K1P5/yampad/img/ROTARY ENCODER MATRIX IDENTIFICATION.JPG

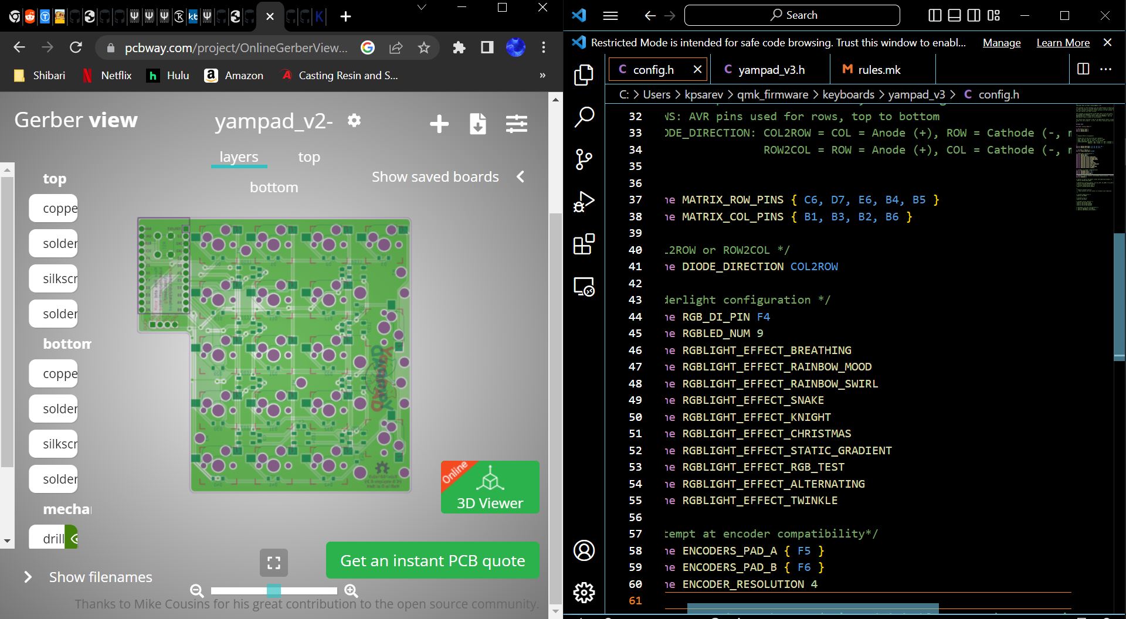
img/ROTARY ENCODER MATRIX IDENTIFICATION.JPG
