K1P5/yampad/pcb/K1P5 KiCAD Updates/Readme

K1P5 updates to Yampad, capturing currently "as-sold" state (rotary encoder + 2u "0" switch socket).
