K1P5/yampad/img/K1P5 YAMPAD PCB, 'AS-SOLD'.PNG

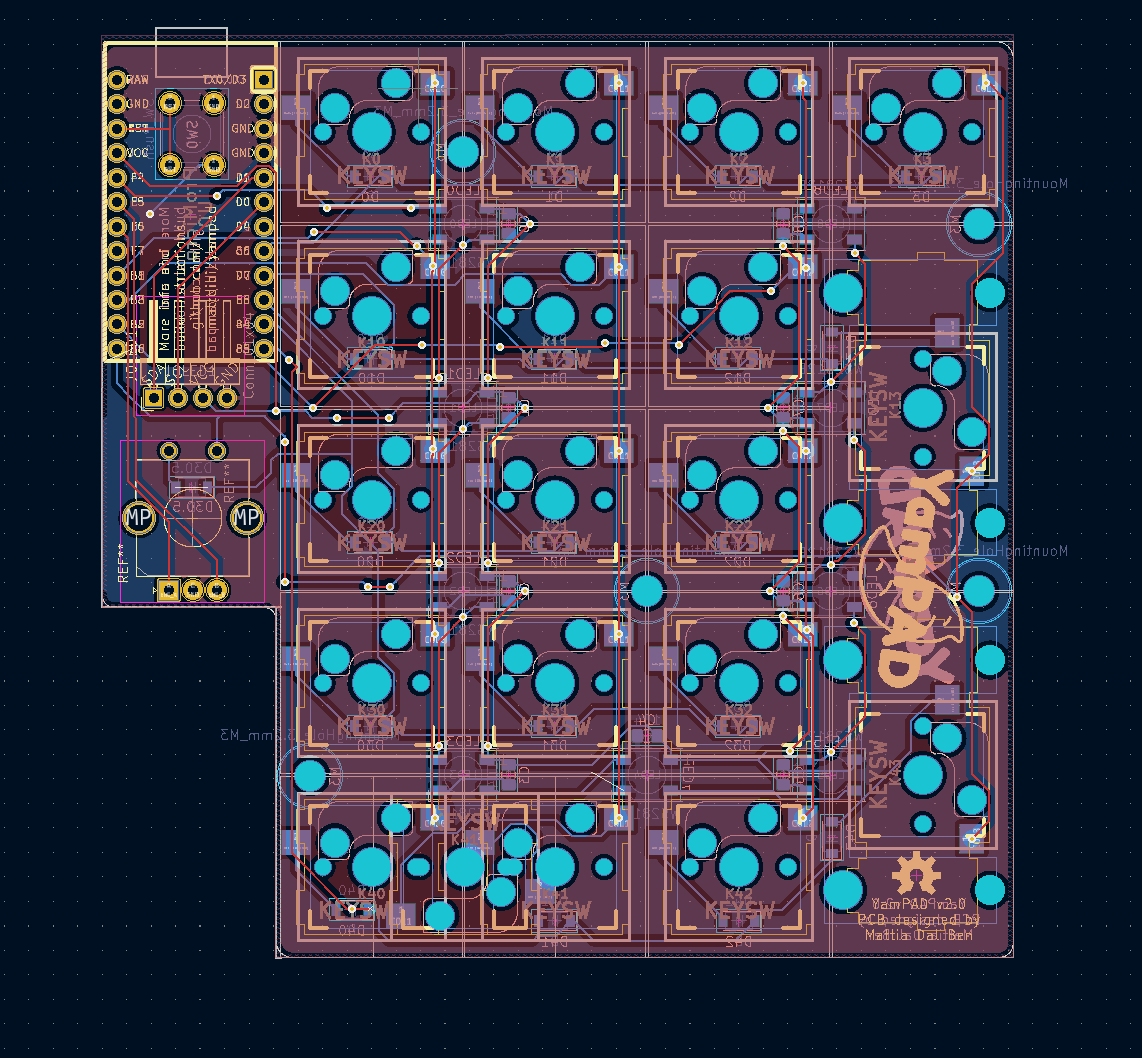
img/K1P5 YAMPAD PCB, 'AS-SOLD'.PNG
