K1P5/yampad/img/ROTARY ENCODER MATRIX IDENTIFICATION IMAGE 2.JPG

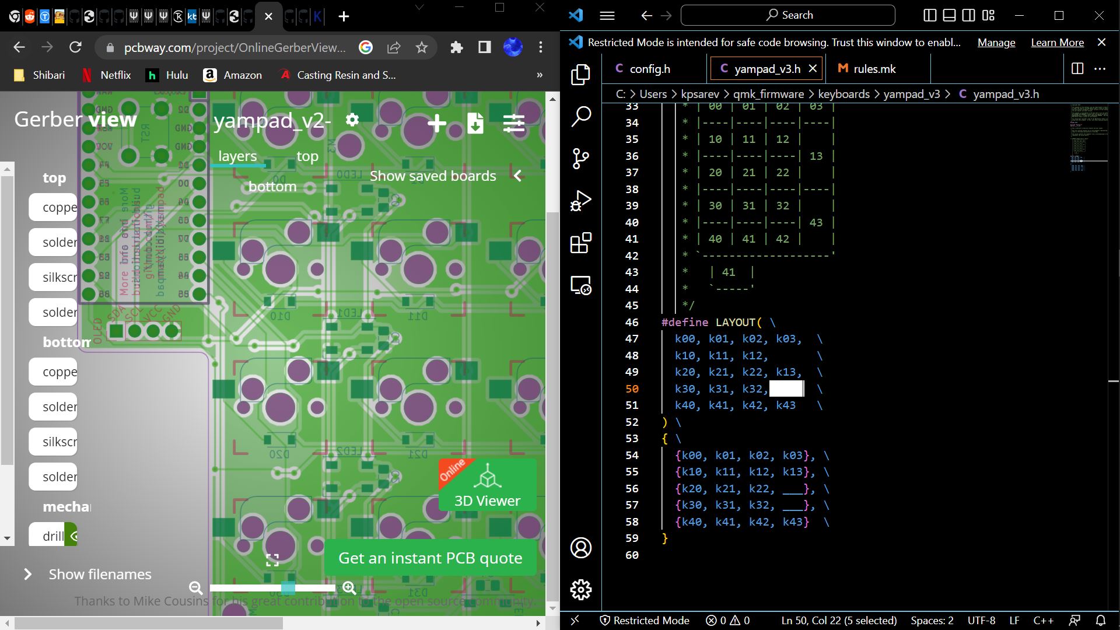
img/ROTARY ENCODER MATRIX IDENTIFICATION IMAGE 2.JPG
