K1P5/yampad/img/YAMPAD 2U '0' UPDATE.PNG

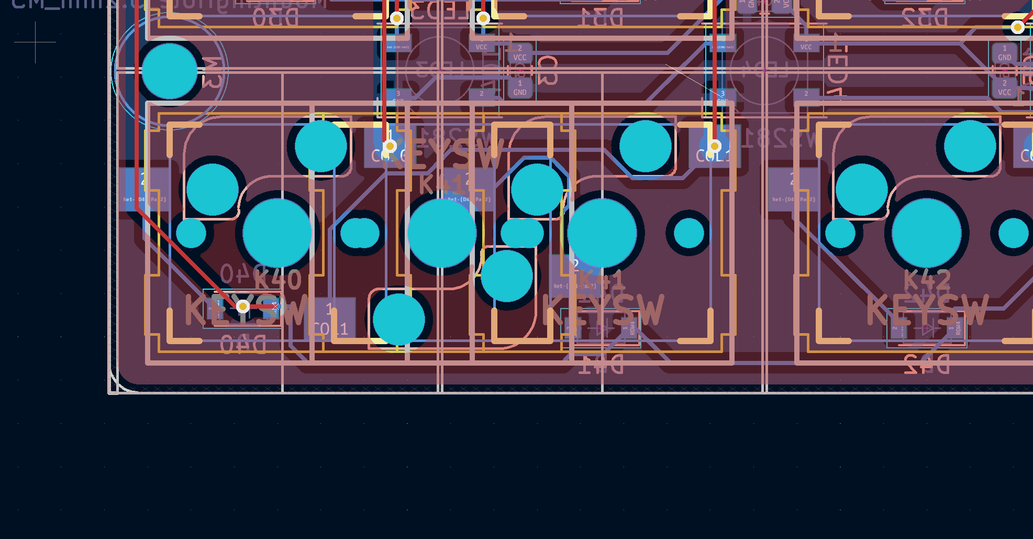
img/YAMPAD 2U '0' UPDATE.PNG
