K1P5/yampad/img/YAMPAD POTENIOMETER PCB UPDATE.PNG

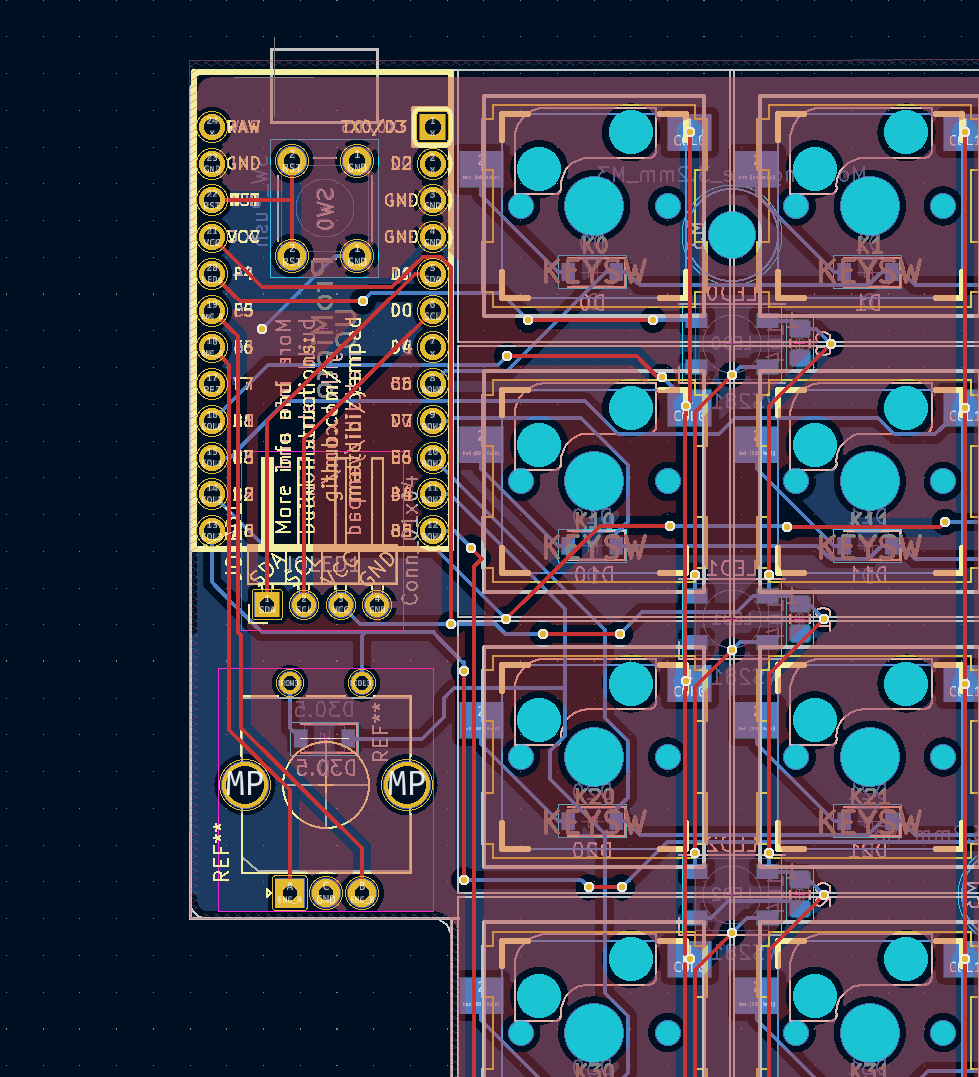
img/YAMPAD POTENIOMETER PCB UPDATE.PNG
