K1P5/yampad/firmware/QMK Files/yampad_v4/yampad_v4/config.h

/*
Copyright 2012 Jun Wako <wakojun@gmail.com>

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
You should have received a copy of the GNU General Public License
along with this program.  If not, see <http://www.gnu.org/licenses/>.
*/

#pragma once

#include "config_common.h"

/* key matrix size */
#define MATRIX_ROWS 5
#define MATRIX_COLS 4


/*
 * Keyboard Matrix Assignments
 *
 * Change this to how you wired your keyboard
 * COLS: AVR pins used for columns, left to right
 * ROWS: AVR pins used for rows, top to bottom
 * DIODE_DIRECTION: COL2ROW = COL = Anode (+), ROW = Cathode (-, marked on diode)
 *                  ROW2COL = ROW = Anode (+), COL = Cathode (-, marked on diode)
 *
*/
#define MATRIX_ROW_PINS { C6, D7, E6, B4, B5 }
#define MATRIX_COL_PINS { B1, B3, B2, B6 }

/* COL2ROW or ROW2COL */
#define DIODE_DIRECTION COL2ROW

/* Underlight configuration */
#define RGB_DI_PIN F4
#define RGBLED_NUM 9
#define RGBLIGHT_EFFECT_BREATHING
#define RGBLIGHT_EFFECT_RAINBOW_MOOD
#define RGBLIGHT_EFFECT_RAINBOW_SWIRL
#define RGBLIGHT_EFFECT_SNAKE
#define RGBLIGHT_EFFECT_KNIGHT
#define RGBLIGHT_EFFECT_CHRISTMAS
#define RGBLIGHT_EFFECT_STATIC_GRADIENT
#define RGBLIGHT_EFFECT_RGB_TEST
#define RGBLIGHT_EFFECT_ALTERNATING
#define RGBLIGHT_EFFECT_TWINKLE

/* attempt at encoder compatibility*/
#define ENCODERS_PAD_A { F6 }
#define ENCODERS_PAD_B { F5 }
#define ENCODER_RESOLUTION 4

/* Debounce reduces chatter (unintended double-presses) - set 0 if debouncing is not needed */
#define DEBOUNCE 2

/* define if matrix has ghost (lacks anti-ghosting diodes) */
//#define MATRIX_HAS_GHOST

/* Mechanical locking support. Use KC_LCAP, KC_LNUM or KC_LSCR instead in keymap */
//#define LOCKING_SUPPORT_ENABLE
/* Locking resynchronize hack */
//#define LOCKING_RESYNC_ENABLE

/*
 * Feature disable options
 *  These options are also useful to firmware size reduction.
 */

/* disable debug print */
//#define NO_DEBUG

/* disable print */
//#define NO_PRINT

/* disable action features */
//#define NO_ACTION_LAYER
//#define NO_ACTION_TAPPING
//#define NO_ACTION_ONESHOT

/* Bootmagic Lite key configuration */
// #define BOOTMAGIC_LITE_ROW 0
// #define BOOTMAGIC_LITE_COLUMN 0
