K1P5/yampad/(commit log)

2023-01-08 Added initial FW hex files
    Added Yampad Via compatible FW for 2u '0' key layout and separate via compatible FW for 2u '0' layout WITH rotary encoder (CW, CCW; no button).
2023-01-08 Create Read ME
    Added Readme file, all QMK FW compiling files (All original Yampad FW files + Wrthg "Yampad_V3" (2u '0' Yampad layout with rotary encoder).
2023-01-11 Add yampad_v4 FW
    2u "0" (default), 1u "00" supported via "yampad_wrthg_2u0_via_enc" keymap.c files. Rotary encoder channel(s) A, B and pushbutton supported.
2023-01-11 Add latest working yampad_v3 QMK files
    Default out of box support for rotary encoder channels A, B (vol up/down) as well as for 2u "0".
2023-01-11 Add latest working yamped_v4 QMK files
    Default out of box support for rotary encoder channels A, B (vol up/down), encoder pushbutton (calculator in base layer/audio mute in nav, RGB layers), as well as for 2u "0" key.
2023-01-11 Add updated yampad_v3 FW file
    Corrected rotary encoder rotational direction.
2023-01-13 Added PCB Updates Readme file
2023-01-13 Added Updated KiCAD files
    Updated PCB and schematic files (and underlying support files) to incorporate the layout currently sold online (rotary encoder A, B channels + button, 2u "0" support).
2023-01-13 Added reference image of current schematic
