K1P5/yampad/(notices)

Notices in the files:
firmware/QMK Files/yampad_v4/yampad_v4/config.h:
This program is free software: you can redistribute it and/or modify
it under the terms of the GNU General Public License as published by
the Free Software Foundation, either version 2 of the License, or
(at your option) any later version.
README.md:
License: MIT
